Medferhy/Driver-Hardware/CurlDrive-2.kicad_pcb

## KiCad design CurlDrive-2.kicad_pcb (2026-08-12)

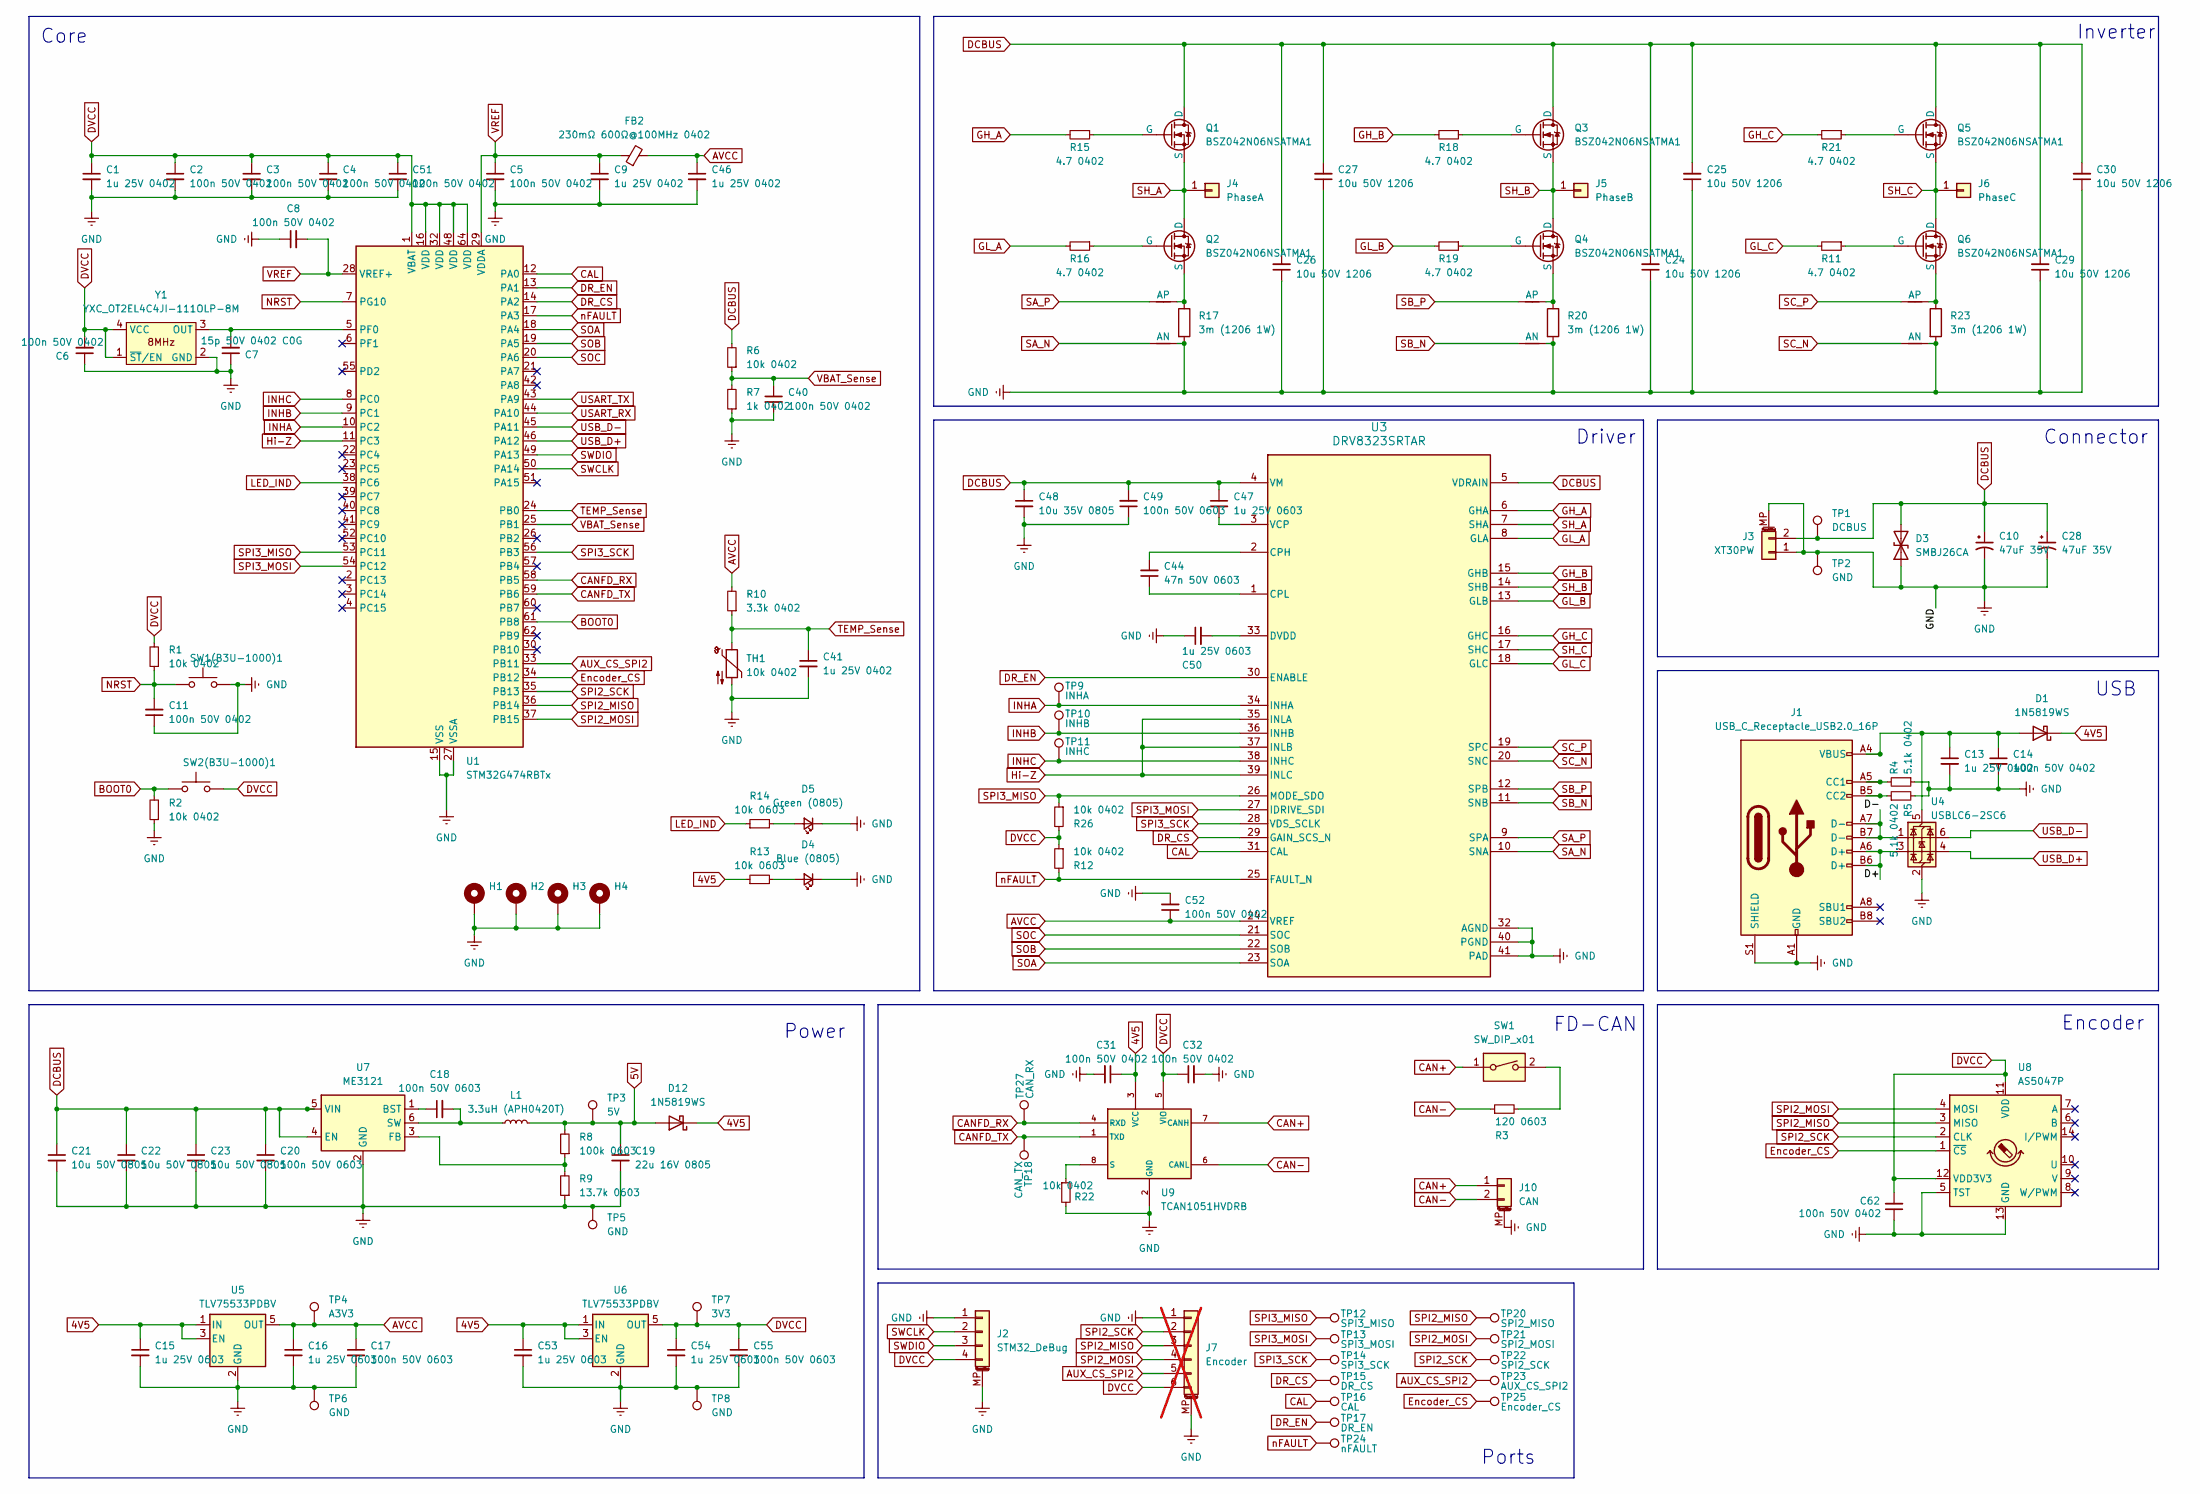
[picture p1: schematic CurlDrive-2.kicad_sch]

Parts:
C1, C9, C13, C41, C46: 1u 25V 0402; C_0402_1005Metric
C2, C3, C4, C5, C6, C8, C11, C14, C31, C32, C40, C51, C52, C62: 100n 50V 0402; C_0402_1005Metric
C7: 15p 50V 0402 C0G; C_0402_1005Metric
C10, C28: 47uF 35V; CP_Elec_6.3x4.9
C15, C16, C47, C50, C53, C54: 1u 25V 0603; C_0603_1608Metric
C17, C18, C20, C49, C55: 100n 50V 0603; C_0603_1608Metric
C19: 22u 16V 0805; C_0805_2012Metric
C21, C22, C23: 10u 50V 0805; C_0805_2012Metric
C24, C25, C26, C27, C29, C30: 10u 50V 1206; C_1206_3216Metric
C44: 47n 50V 0603; C_0603_1608Metric
C48: 10u 35V 0805; C_0805_2012Metric
D1, D12: 1N5819WS; D_SOD-323
D3: SMBJ26CA; D_SMB
D4: Blue (0805); LED_0805_2012Metric
D5: Green (0805); LED_0805_2012Metric
FB2: 230mΩ 600Ω@100MHz 0402; R_0402_1005Metric
H1, H2, H3, H4: MountingHole_Pad_MP; MountingHole_2.2mm_M2_DIN965_Pad
J1: USB_C_Receptacle_USB2.0_16P; USB_C_Receptacle_G-Switch_GT-USB-7010ASV
J2: STM32_DeBug; JST_SH_SM04B-SRSS-TB_1x04-1MP_P1.00mm_Horizontal
J3: XT30PW; AMASS_XT30PW-M_1x02_P2.50mm_Horizontal
J4: PhaseA; 4.5x4.5_pad
J5: PhaseB; 4.5x4.5_pad
J6: PhaseC; 4.5x4.5_pad
J7: Encoder; JST_SH_SM06B-SRSS-TB_1x06-1MP_P1.00mm_Horizontal; not fitted
J10: CAN; JST_SH_SM02B-SRSS-TB_1x02-1MP_P1.00mm_Horizontal
L1: 3.3uH (APH0420T); L_APV_APH0420
NT1, NT3, NT5: AP; NetTie-2
NT2, NT4, NT6: AN; NetTie-2
Q1, Q2, Q3, Q4, Q5, Q6: BSZ042N06NSATMA1; PG-TSDSON-8
R1, R2, R6, R12, R22, R26: 10k 0402; R_0402_1005Metric
R3: 120 0603; R_0603_1608Metric
R4, R5: 5.1k 0402; R_0402_1005Metric
R7: 1k 0402; R_0402_1005Metric
R8: 100k 0603; R_0603_1608Metric
R9: 13.7k 0603; R_0603_1608Metric
R10: 3.3k 0402; R_0402_1005Metric
R11, R15, R16, R18, R19, R21: 4.7 0402; R_0402_1005Metric
R13, R14: 10k 0603; R_0603_1608Metric
R17, R20, R23: 3m (1206 1W); R_1206_3216Metric
SW1: SW_DIP_x01; SW_SPST_DSHP-01-TJ-GER
SW1(B3U-1000)1, SW2(B3U-1000)1: SW_Push; SW_SPST_B3U-1000P
TH1: 10k 0402; R_0402_1005Metric
TP1: DCBUS; TestPoint_Pad_D0.4mm
TP2, TP5, TP6, TP8: GND; TestPoint_Pad_D0.4mm
TP3: 5V; TestPoint_Pad_D0.4mm
TP4: A3V3; TestPoint_Pad_D0.4mm
TP7: 3V3; TestPoint_Pad_D0.4mm
TP9: INHA; TestPoint_Pad_D0.4mm
TP10: INHB; TestPoint_Pad_D0.4mm
TP11: INHC; TestPoint_Pad_D0.4mm
TP12: SPI3_MISO; TestPoint_Pad_D0.4mm
TP13: SPI3_MOSI; TestPoint_Pad_D0.4mm
TP14: SPI3_SCK; TestPoint_Pad_D0.4mm
TP15: DR_CS; TestPoint_Pad_D0.4mm
TP16: CAL; TestPoint_Pad_D0.4mm
TP17: DR_EN; TestPoint_Pad_D0.4mm
TP18: CAN_TX; TestPoint_Pad_D0.4mm
TP20: SPI2_MISO; TestPoint_Pad_D0.4mm
TP21: SPI2_MOSI; TestPoint_Pad_D0.4mm
TP22: SPI2_SCK; TestPoint_Pad_D0.4mm
TP23: AUX_CS_SPI2; TestPoint_Pad_D0.4mm
TP24: nFAULT; TestPoint_Pad_D0.4mm
TP25: Encoder_CS; TestPoint_Pad_D0.4mm
TP27: CAN_RX; TestPoint_Pad_D0.4mm
U1: STM32G474RBTx; LQFP-64_10x10mm_P0.5mm
U3: DRV8323SRTAR; DRV8323
U4: USBLC6-2SC6; SOT-23-6
U5, U6: TLV75533PDBV; SOT-23-5
U7: ME3121; SOT-23-6
U8: AS5047P; TSSOP-14_4.4x5mm_P0.65mm
U9: TCAN1051HVDRB; TCAN1051VDRB
Y1: YXC_OT2EL4C4JI-111OLP-8M; Crystal_SMD_3225-4Pin_3.2x2.5mm

Connections:
4V5: C15.1, C31.1, C53.1, D1.1 (K), D12.1 (K), R13.1, U5.1 (IN), U5.3 (EN), U6.1 (IN), U6.3 (EN), U9.3 (VCC)
5V: C19.1, D12.2 (A), L1.2, R8.2, TP3.1
/D+: J1.A6 (D+), J1.B6 (D+), U4.3 (I/O2)
/D-: J1.A7 (D-), J1.B7 (D-), U4.1 (I/O1)
AUX_CS_SPI2: J7.5, TP23.1, U1.33 (PB11)
AVCC: C16.1, C17.1, C46.1, C52.1, FB2.2, R10.2, TP4.1, U3.24 (VREF), U5.5 (OUT)
BOOT0: R2.2, SW2(B3U-1000)1.1, U1.61 (PB8)
CAL: TP16.1, U1.12 (PA0), U3.31 (CAL)
CAN+: J10.1, SW1.1, U9.7 (CANH)
CAN-: J10.2, R3.1, U9.6 (CANL)
CANFD_RX: TP27.1, U1.58 (PB5), U9.4 (RXD)
CANFD_TX: TP18.1, U1.59 (PB6), U9.1 (TXD)
DCBUS: C10.1, C20.1, C21.1, C22.1, C23.1, C24.2, C25.2, C26.2, C27.2, C28.1, C29.2, C30.2, C47.1, C48.1, C49.2, D3.2 (A2), J3.2, Q1.1 (D), Q3.1 (D), Q5.1 (D), R6.2, TP1.1, U3.4 (VM), U3.5 (VDRAIN), U7.4 (EN), U7.5 (VIN)
DR_CS: TP15.1, U1.14 (PA2), U3.29 (GAIN_SCS_N)
DR_EN: TP17.1, U1.13 (PA1), U3.30 (ENABLE)
DVCC: C1.1, C2.1, C3.1, C4.1, C6.2, C32.1, C51.1, C54.1, C55.1, C62.2, J2.4, J7.6, R1.2, R12.1, R26.2, SW2(B3U-1000)1.2, TP7.1, U1.1 (VBAT), U1.16 (VDD), U1.32 (VDD), U1.48 (VDD), U1.64 (VDD), U6.5 (OUT), U8.11 (VDD), U8.12 (VDD3V3), U9.5 (VIO), Y1.1 (~ST/EN), Y1.4 (VCC)
Encoder_CS: TP25.1, U1.34 (PB12), U8.1 (~CS)
GH_A: R15.2, U3.6 (GHA)
GH_B: R18.2, U3.15 (GHB)
GH_C: R21.2, U3.16 (GHC)
GL_A: R16.2, U3.8 (GLA)
GL_B: R19.2, U3.13 (GLB)
GL_C: R11.2, U3.18 (GLC)
GND: C1.2, C2.2, C3.2, C4.2, C5.2, C6.1, C7.1, C8.1, C9.2, C10.2, C11.1, C13.2, C14.2, C15.2, C16.2, C17.2, C19.2, C20.2, C21.2, C22.2, C23.2, C24.1, C25.1, C26.1, C27.1, C28.2, C29.1, C30.1, C31.2, C32.2, C40.2, C41.2, C46.2, C48.2, C49.1, C50.1, C51.2, C52.2, C53.2, C54.2, C55.2, C62.1, D3.1 (A1), D4.1 (K), D5.1 (K), H1.MP, H2.MP, H3.MP, H4.MP, J1.A1 (GND), J1.A12 (GND), J1.B1 (GND), J1.B12 (GND), J1.S1 (SHIELD), J2.1, J2.MP (MountPin), J3.1, J3.MP (MountPin), J7.1, J7.MP (MountPin), J10.MP (MountPin), NT2.2, NT4.2, NT6.2, R2.1, R4.1, R5.2, R7.1, R9.1, R17.2, R20.2, R22.2, R23.2, SW1(B3U-1000)1.2, TH1.2, TP2.1, TP5.1, TP6.1, TP8.1, U1.15 (VSS), U1.27 (VSSA), U1.31 (VSS), U1.47 (VSS), U1.63 (VSS), U3.32 (AGND), U3.40 (PGND), U3.41 (PAD), U4.2 (GND), U5.2 (GND), U6.2 (GND), U7.2 (GND), U8.5 (TST), U8.13 (GND), U9.2 (GND), Y1.2 (GND)
Hi-Z: U1.11 (PC3), U3.35 (INLA), U3.37 (INLB), U3.39 (INLC)
INHA: TP9.1, U1.10 (PC2), U3.34 (INHA)
INHB: TP10.1, U1.9 (PC1), U3.36 (INHB)
INHC: TP11.1, U1.8 (PC0), U3.38 (INHC)
LED_IND: R14.1, U1.38 (PC6)
NRST: C11.2, R1.1, SW1(B3U-1000)1.1, U1.7 (PG10)
unnamed: C13.1, C14.1, D1.2 (A), J1.A4 (VBUS), J1.A9 (VBUS), J1.B4 (VBUS), J1.B9 (VBUS), U4.5 (VBUS)
unnamed: D4.2 (A), R13.2
unnamed: D5.2 (A), R14.2
unnamed: J1.A5 (CC1), R4.2
unnamed: J1.B5 (CC2), R5.1
unnamed: Q1.2 (G), R15.1
unnamed: Q2.2 (G), R16.1
unnamed: NT1.2, Q2.3 (S), R17.1
unnamed: Q3.2 (G), R18.1
unnamed: Q4.2 (G), R19.1
unnamed: NT3.2, Q4.3 (S), R20.1
unnamed: Q5.2 (G), R21.1
unnamed: Q6.2 (G), R11.1
unnamed: NT5.2, Q6.3 (S), R23.1
unnamed: R3.2, SW1.2
unnamed: C7.2, U1.5 (PF0), Y1.3 (OUT)
unnamed: C44.2, U3.2 (CPH)
unnamed: C44.1, U3.1 (CPL)
unnamed: C50.2, U3.33 (DVDD)
unnamed: C47.2, U3.3 (VCP)
unnamed: C18.1, U7.1 (BST)
unnamed: R8.1, R9.2, U7.3 (FB)
unnamed: C18.2, L1.1, U7.6 (SW)
unnamed: R22.1, U9.8 (S)
SA_N: NT2.1, U3.10 (SNA)
SA_P: NT1.1, U3.9 (SPA)
SB_N: NT4.1, U3.11 (SNB)
SB_P: NT3.1, U3.12 (SPB)
SC_N: NT6.1, U3.20 (SNC)
SC_P: NT5.1, U3.19 (SPC)
SH_A: J4.1, Q1.3 (S), Q2.1 (D), U3.7 (SHA)
SH_B: J5.1, Q3.3 (S), Q4.1 (D), U3.14 (SHB)
SH_C: J6.1, Q5.3 (S), Q6.1 (D), U3.17 (SHC)
SOA: U1.18 (PA4), U3.23 (SOA)
SOB: U1.19 (PA5), U3.22 (SOB)
SOC: U1.20 (PA6), U3.21 (SOC)
SPI2_MISO: J7.3, TP20.1, U1.36 (PB14), U8.3 (MISO)
SPI2_MOSI: J7.4, TP21.1, U1.37 (PB15), U8.4 (MOSI)
SPI2_SCK: J7.2, TP22.1, U1.35 (PB13), U8.2 (CLK)
SPI3_MISO: R26.1, TP12.1, U1.53 (PC11), U3.26 (MODE_SDO)
SPI3_MOSI: TP13.1, U1.54 (PC12), U3.27 (IDRIVE_SDI)
SPI3_SCK: TP14.1, U1.56 (PB3), U3.28 (VDS_SCLK)
SWCLK: J2.2, U1.50 (PA14)
SWDIO: J2.3, U1.49 (PA13)
TEMP_Sense: C41.1, R10.1, TH1.1, U1.24 (PB0)
USART_RX: U1.44 (PA10)
USART_TX: U1.43 (PA9)
USB_D+: U1.46 (PA12), U4.4 (I/O2)
USB_D-: U1.45 (PA11), U4.6 (I/O1)
VBAT_Sense: C40.1, R6.1, R7.2, U1.25 (PB1)
VREF: C5.1, C8.2, C9.1, FB2.1, U1.28 (VREF+), U1.29 (VDDA)
nFAULT: R12.2, TP24.1, U1.17 (PA3), U3.25 (FAULT_N)

Notes on the sheet:
Power
Core
Driver
Ports
Encoder
USB
Connector
Inverter
FD-CAN

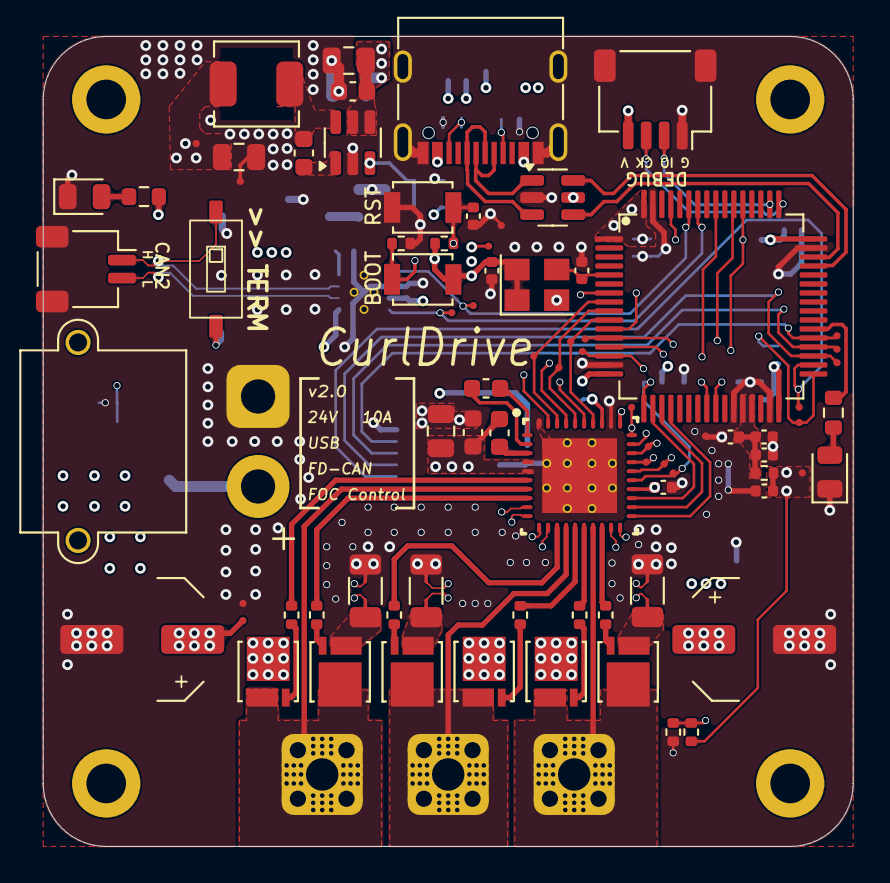
[picture p2: board CurlDrive-2.kicad_pcb from above]

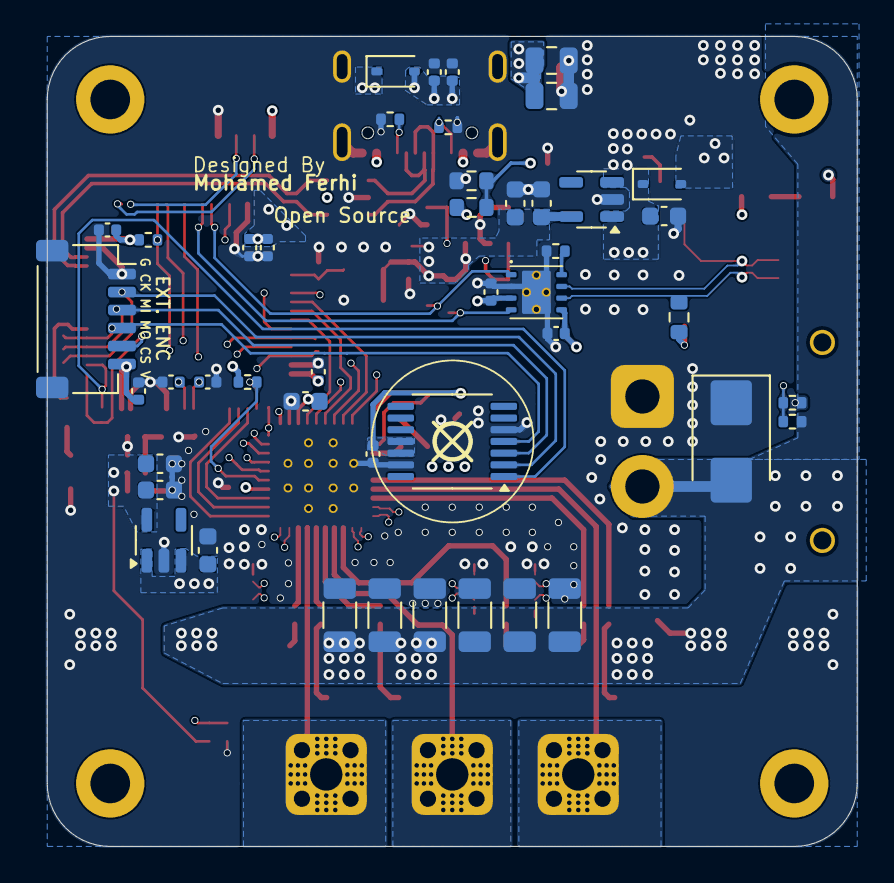
[picture p3: board CurlDrive-2.kicad_pcb from below]

Board: 6 copper layers, 45.0 x 45.0 mm, 138 parts (45 on the bottom side), 80 nets.
